Michael-Manning/Templog_PCB/Lenny_face.png

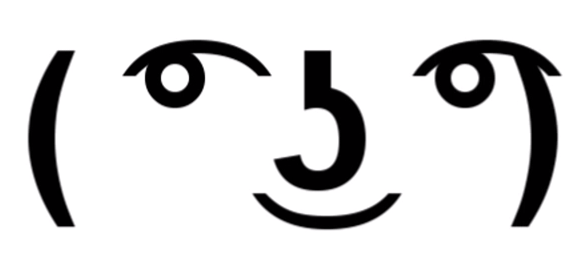
Lenny_face.png
