Michael-Manning/Templog_PCB/CAD/asm.FCStd

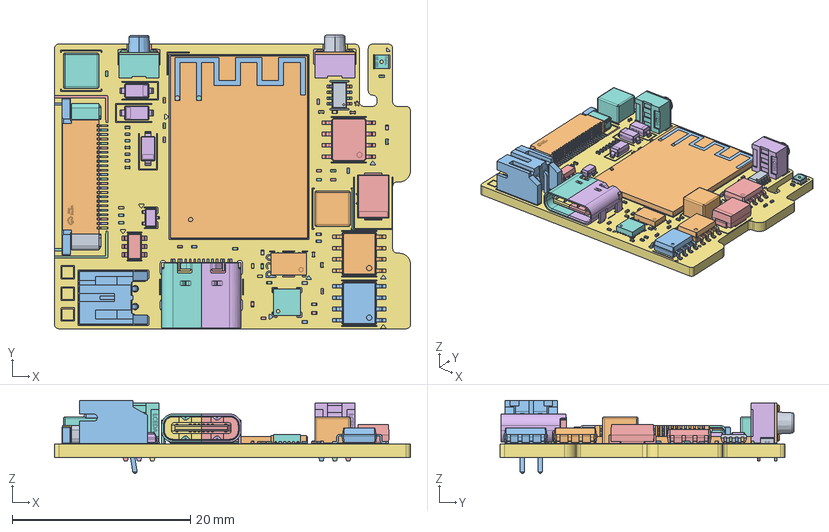
[picture p2: CAD file, 2025-06-27]
CAD/asm.FCStd
40.0 x 33.0 x 8.25 mm
C_0201_0603Metric
C_0201_0603Metric001
R_0201_0603Metric
C_0201_0603Metric002
SOT-23-6
C_0201_0603Metric003
C_0201_0603Metric004
C_0201_0603Metric005
R_0201_0603Metric001
SOIC-8_3.9x4.9mm_P1.27mm
C_0201_0603Metric006
R_0201_0603Metric002
R_0201_0603Metric003
R_0201_0603Metric004
C_0201_0603Metric007
R_0201_0603Metric005
C_0201_0603Metric008
Texas_S-PDSO-N12
JST_PH_S2B-PH-K_1x02_P2.00mm_Horizontal
C_0201_0603Metric009
R_0201_0603Metric006
D_SOD-123
FPC-SMD_AFC07-S24ECA-00
FPC-SMD_AFC07-S24ECA-001
FPC-SMD_AFC07-S24ECA-002
FPC-SMD_AFC07-S24ECA-003
FPC-SMD_AFC07-S24ECA-004
FPC-SMD_AFC07-S24ECA-005
FPC-SMD_AFC07-S24ECA-006
FPC-SMD_AFC07-S24ECA-007
FPC-SMD_AFC07-S24ECA-008
FPC-SMD_AFC07-S24ECA-009
FPC-SMD_AFC07-S24ECA-010
FPC-SMD_AFC07-S24ECA-011
FPC-SMD_AFC07-S24ECA-012
FPC-SMD_AFC07-S24ECA-013
FPC-SMD_AFC07-S24ECA-014
FPC-SMD_AFC07-S24ECA-015
FPC-SMD_AFC07-S24ECA-016
FPC-SMD_AFC07-S24ECA-017
FPC-SMD_AFC07-S24ECA-018
FPC-SMD_AFC07-S24ECA-019
FPC-SMD_AFC07-S24ECA-020
FPC-SMD_AFC07-S24ECA-021
FPC-SMD_AFC07-S24ECA-022
FPC-SMD_AFC07-S24ECA-023
FPC-SMD_AFC07-S24ECA-024
FPC-SMD_AFC07-S24ECA-025
FPC-SMD_AFC07-S24ECA-026
FPC-SMD_AFC07-S24ECA-027
SOIC-8_3.9x4.9mm_P1.27mm001
C_0201_0603Metric010
R_0201_0603Metric007
SOT-323_SC-70
C_0201_0603Metric011
R_0201_0603Metric008
R_0201_0603Metric009
C_0201_0603Metric012
R_0201_0603Metric010
C_0201_0603Metric013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
