Michael-Manning/Templog_PCB/CAD/display.FCStd

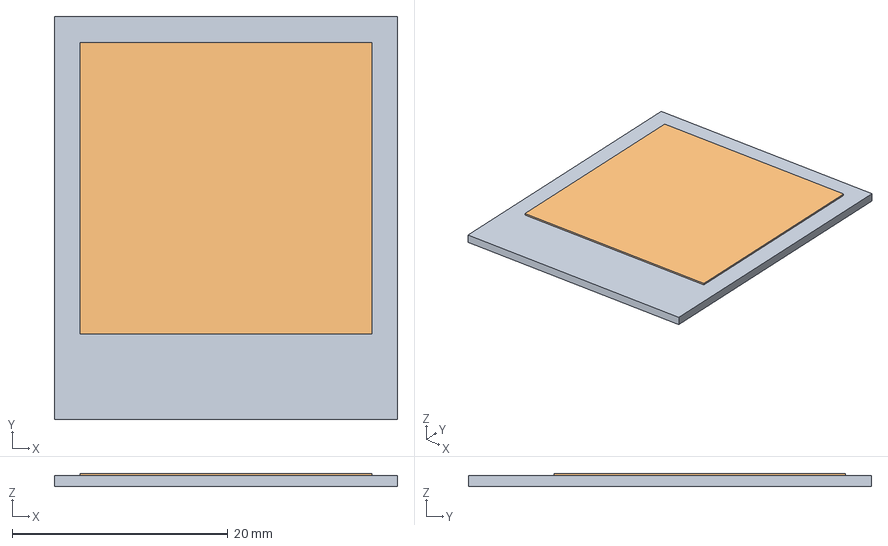
[picture p3: CAD file, 2025-06-27]
CAD/display.FCStd
31.8 x 37.3 x 1.20 mm
