Michael-Manning/Templog_PCB/templog_mainboard/PartLibrary/ESP32_S3_MINI_1/3DModel/ESP32-S3-MINI-1.STEP

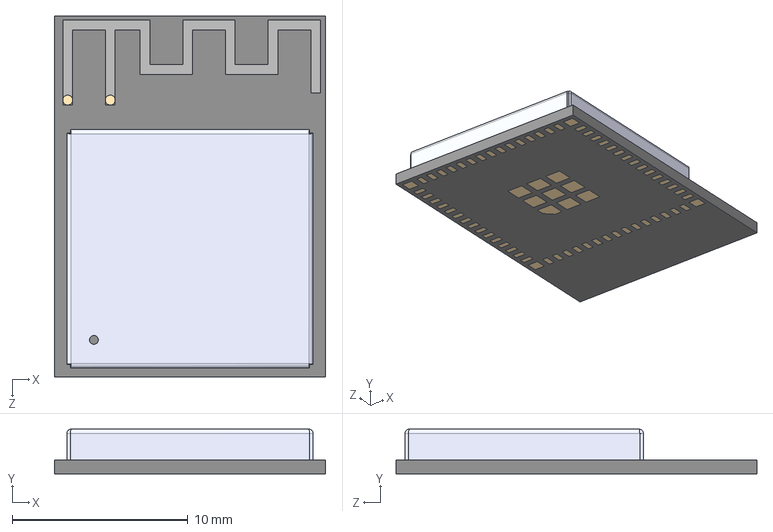
[picture p4: CAD file, 2025-06-13]
templog_mainboard/PartLibrary/ESP32_S3_MINI_1/3DModel/ESP32-S3-MINI-1.STEP
15.4 x 2.55 x 20.5 mm
