Michael-Manning/Templog_PCB/templog_mainboard/PartLibrary/K2-1109DE-D4SW-01/3DModel/KEY-TH_K2-L4.5-W2.9-H4.5-P3.0.step

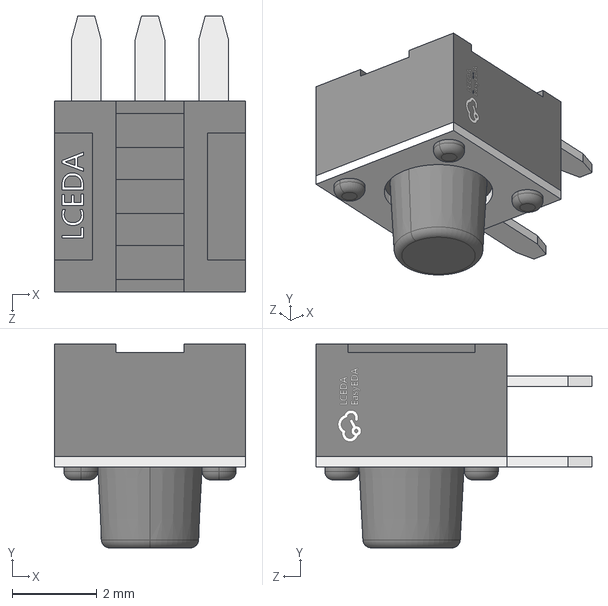
[picture p5: CAD file, 2025-06-16]
templog_mainboard/PartLibrary/K2-1109DE-D4SW-01/3DModel/KEY-TH_K2-L4.5-W2.9-H4.5-P3.0.step
4.50 x 4.80 x 6.50 mm
