Michael-Manning/Templog_PCB/templog_mainboard/PartLibrary/LTC2954CTS8_2_TRMPBF/3DModel/LTC2954CTS8-2_TRMPBF.step

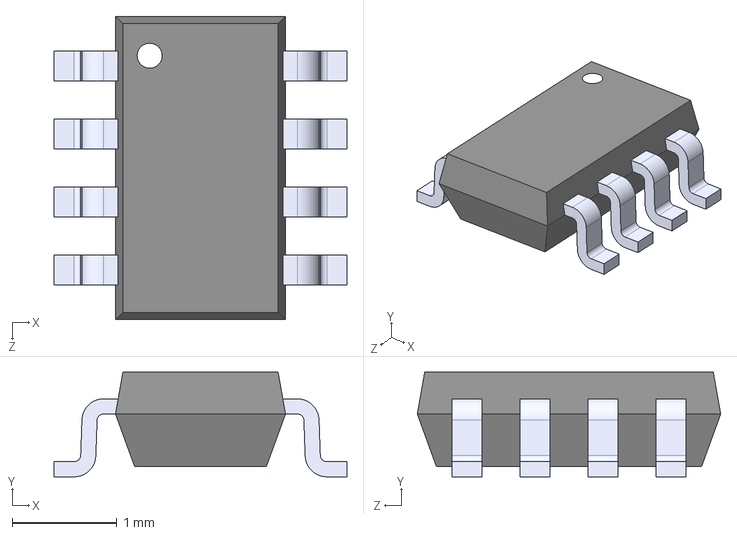
[picture p6: CAD file, 2025-06-17]
templog_mainboard/PartLibrary/LTC2954CTS8_2_TRMPBF/3DModel/LTC2954CTS8-2_TRMPBF.step
2.80 x 1.00 x 2.90 mm
