Michael-Manning/Templog_PCB/templog_mainboard/PartLibrary/SHT45/3DModel/SHT45-AD1B-R3.step

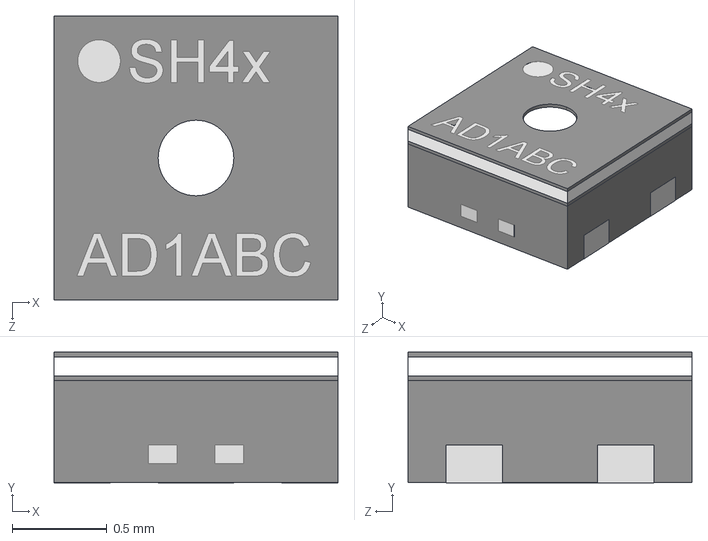
[picture p7: CAD file, 2025-06-16]
templog_mainboard/PartLibrary/SHT45/3DModel/SHT45-AD1B-R3.step
1.50 x 0.691 x 1.50 mm
