Michael-Manning/Templog_PCB/templog_mainboard/PartLibrary/SN74LVC1G79DBVR/3DModel/SN74LVC1G79DBVR.step

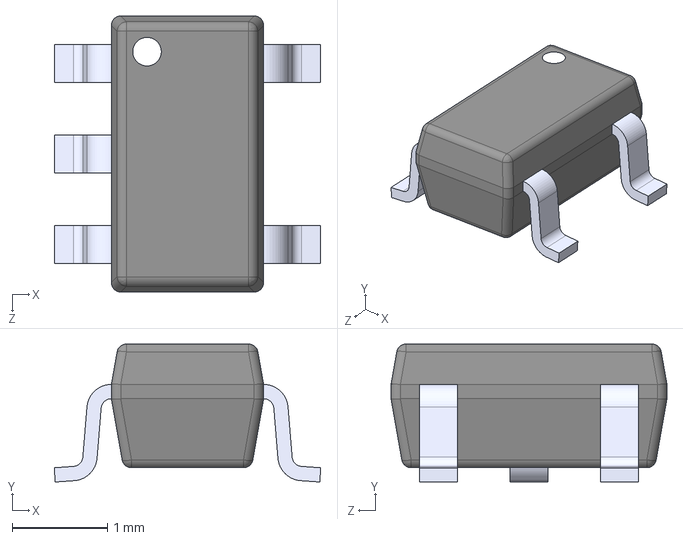
[picture p8: CAD file, 2025-06-13]
templog_mainboard/PartLibrary/SN74LVC1G79DBVR/3DModel/SN74LVC1G79DBVR.step
2.80 x 1.45 x 2.90 mm
