Michael-Manning/Templog_PCB/templog_mainboard/PartLibrary/TPS3422EGDRYR/3DModel/DRY0006A.stp

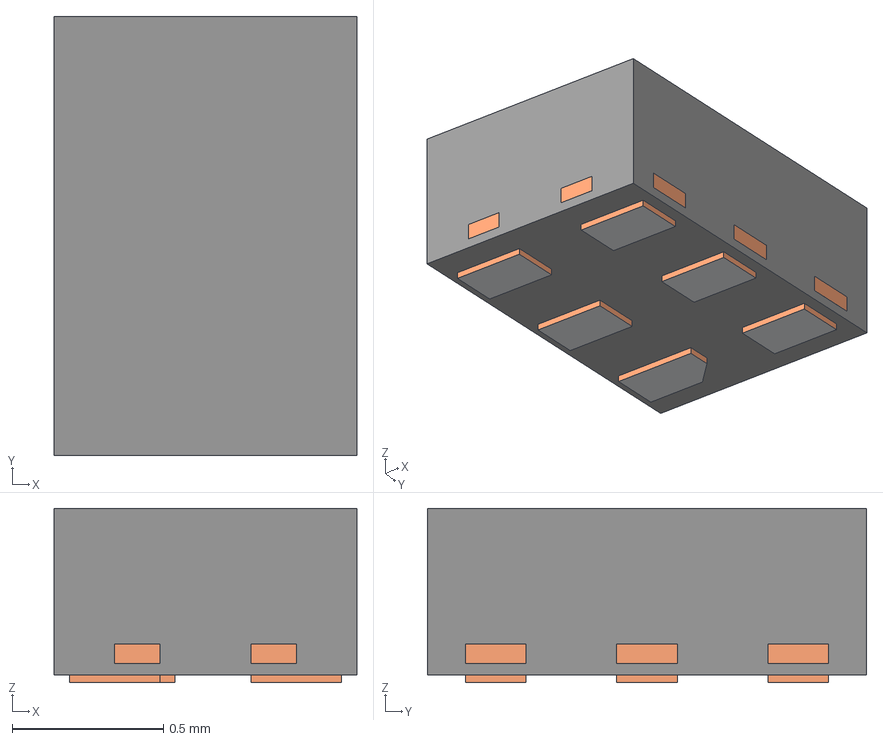
[picture p9: CAD file, 2025-06-13]
templog_mainboard/PartLibrary/TPS3422EGDRYR/3DModel/DRY0006A.stp
1.00 x 1.45 x 0.575 mm
BODY-SON
FRAME-DRY0006A
PIN1-ID
