Michael-Manning/Templog_PCB/CAD/front_plate.FCStd

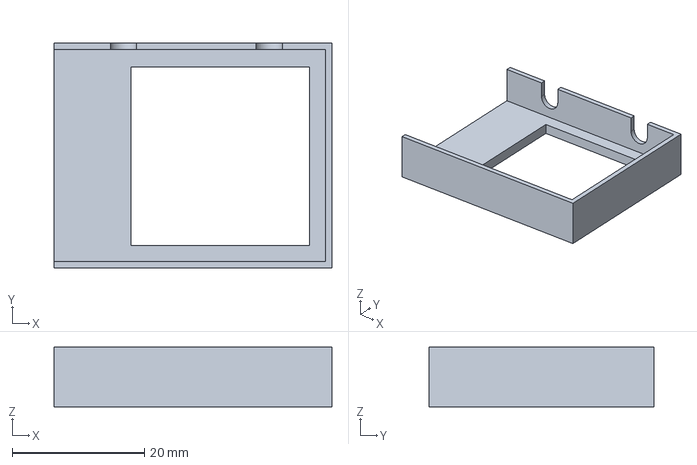
[picture p10: CAD file, 2025-06-27]
CAD/front_plate.FCStd
42.0 x 34.0 x 9.00 mm
