Michael-Manning/Templog_PCB/templog_mainboard/PartLibrary/BQ24075RGT/3DModel/BQ24075RGTR.step

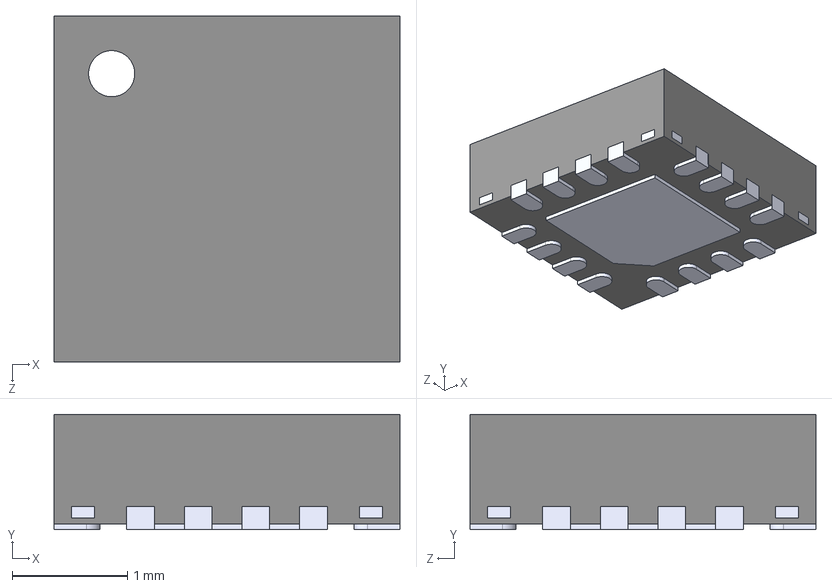
[picture p11: CAD file, 2025-06-16]
templog_mainboard/PartLibrary/BQ24075RGT/3DModel/BQ24075RGTR.step
3.00 x 1.00 x 3.00 mm
