Michael-Manning/Templog_PCB/templog_mainboard/templog_mainboard.kicad_pcb

## KiCad design templog_mainboard/templog_mainboard.kicad_pcb (2025-07-05)

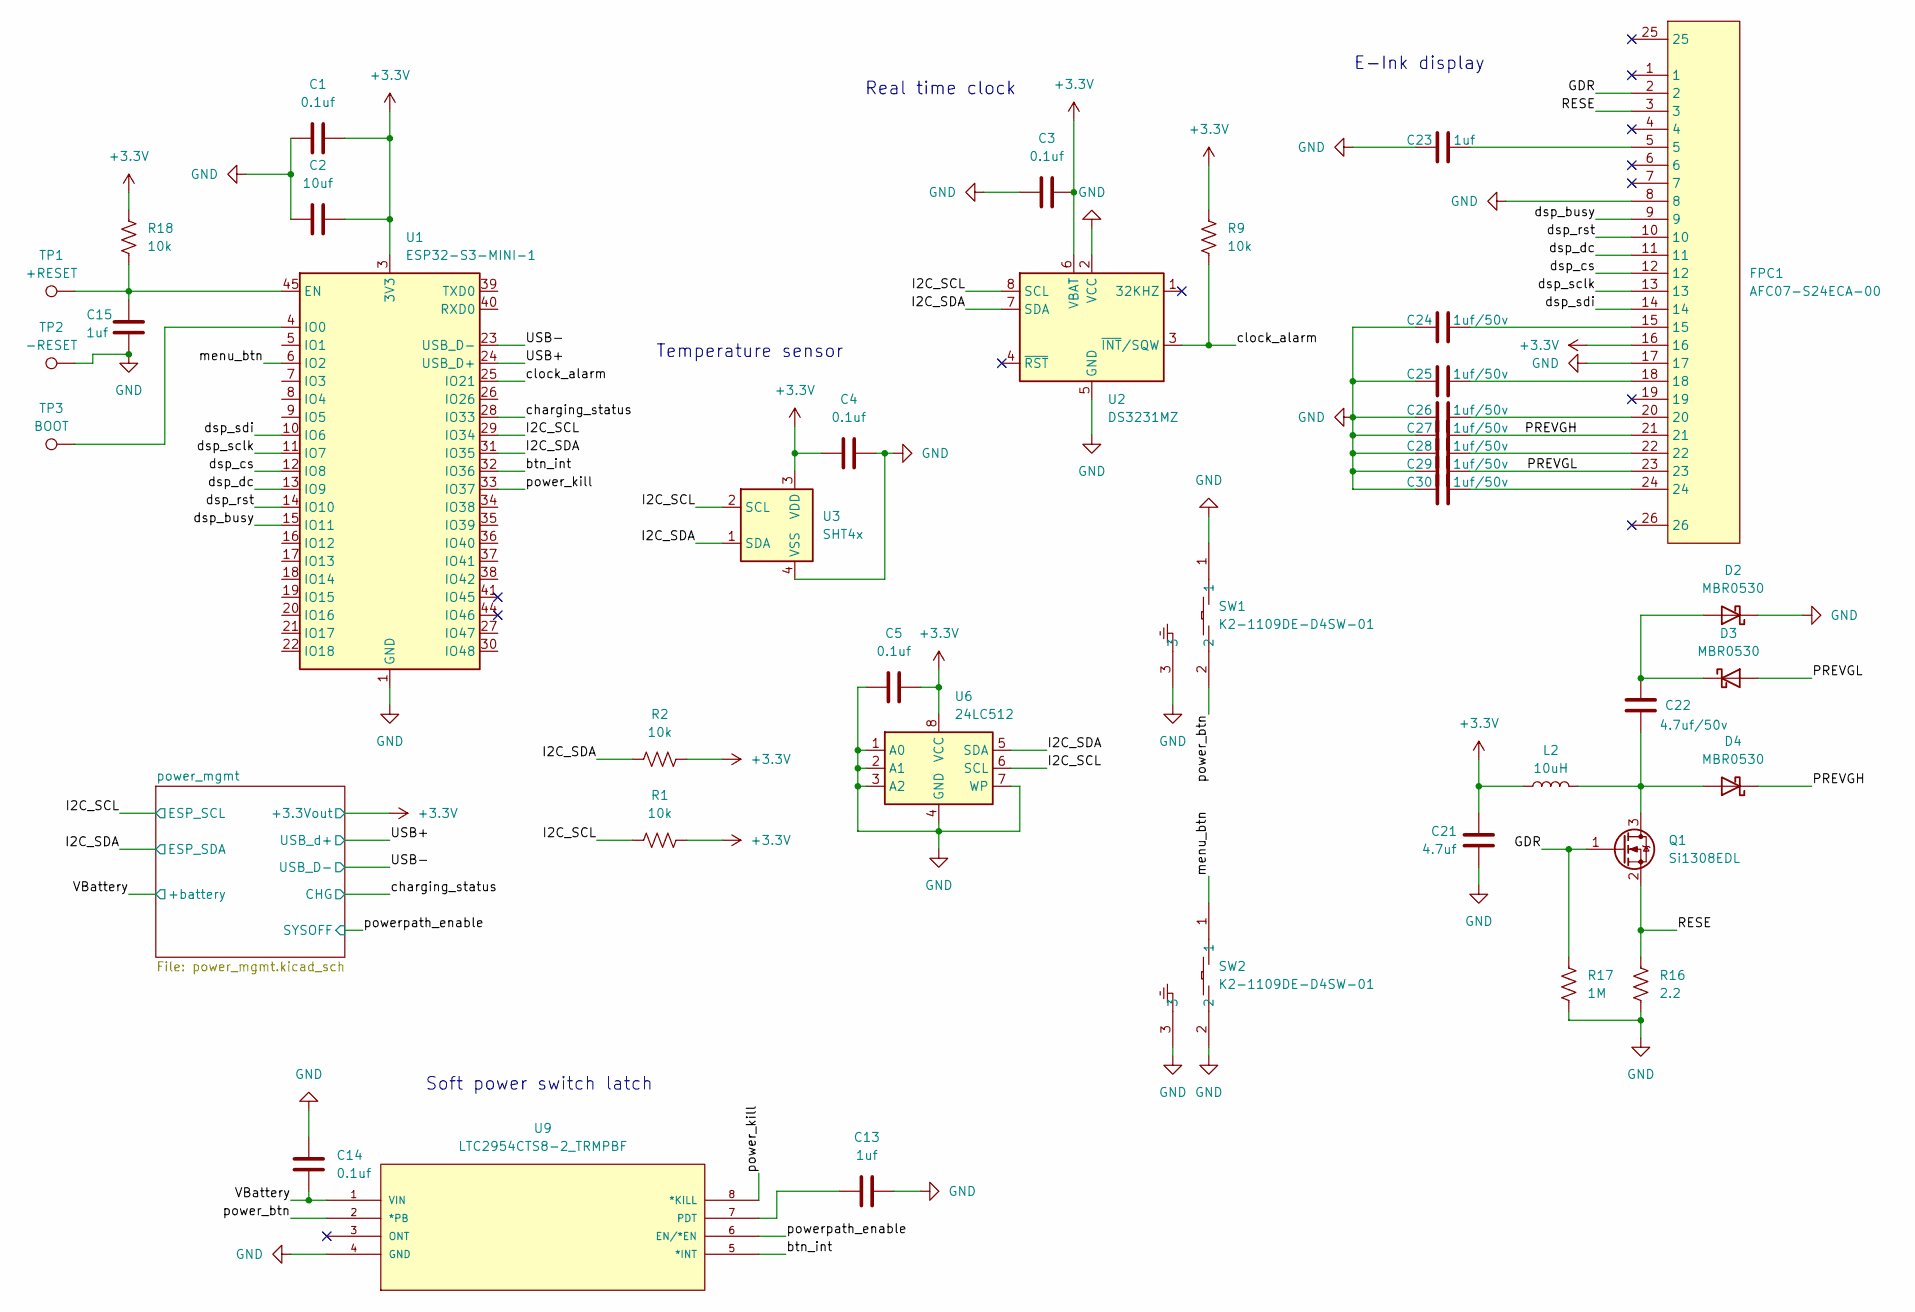
[picture p12: schematic templog_mainboard.kicad_sch]

Parts:
C1, C3, C4, C5, C14: 0.1uf; C_0402_1005Metric
C2: 10uf; C_0805_2012Metric
C13, C23: 1uf; C_0603_1608Metric
C15: 1uf; C_0402_1005Metric
C21: 4.7uf; C_0603_1608Metric
C22: 4.7uf/50v; C_0603_1608Metric
C24, C25, C26, C27, C28, C29, C30: 1uf/50v; C_0603_1608Metric
D2, D3, D4: MBR0530; D_SOD-123
FPC1: AFC07-S24ECA-00; FPC-SMD_AFC07-S24ECA-00; LCSC Part C262643
L2: 10uH; L_Sunlord_SWPA4030S
Q1: Si1308EDL; SOT-323_SC-70
R1, R2, R9, R18: 10k; R_0402_1005Metric
R16: 2.2; R_0402_1005Metric
R17: 1M; R_0402_1005Metric
SW1, SW2: K2-1109DE-D4SW-01; KEY-TH_K2-1109DE-CXXW-XX; LCSC Part C223806
TP1: +RESET; TestPoint_Pad_1.0x1.0mm
TP2: -RESET; TestPoint_Pad_1.0x1.0mm
TP3: BOOT; TestPoint_Pad_1.0x1.0mm
U1: ESP32-S3-MINI-1; ESP32-S2-MINI-1
U2: DS3231MZ; SOIC-8_3.9x4.9mm_P1.27mm
U3: SHT4x; Sensirion_DFN-4_1.5x1.5mm_P0.8mm_SHT4x_NoCentralPad
U6: 24LC512; SOIC-8_3.9x4.9mm_P1.27mm
U9: LTC2954CTS8-2_TRMPBF; TSOT-23_TS8; MANUFACTURER_PART_NUMBER ltc2954cts81

Connections:
+3.3V: C1.2, C2.2, C3.2, C4.1, C5.2, C21.1, FPC1.16, L2.1, R1.2, R2.2, R9.1, R18.1, U1.3 (3V3), U2.6 (VBAT), U3.3 (VDD), U6.8 (VCC); also elsewhere on the board
/GDR: FPC1.2, Q1.1 (G), R17.2
/I2C_SCL: R1.1, U1.29 (IO34), U2.8 (SCL), U3.2 (SCL), U6.6 (SCL); also elsewhere on the board
/I2C_SDA: R2.1, U1.31 (IO35), U2.7 (SDA), U3.1 (SDA), U6.5 (SDA); also elsewhere on the board
/PREVGH: C27.2, D4.1 (K), FPC1.21
/PREVGL: C29.2, D3.2 (A), FPC1.23
/RESE: FPC1.3, Q1.2 (S), R16.2
/USB+: U1.24 (USB_D+); also elsewhere on the board
/USB-: U1.23 (USB_D-); also elsewhere on the board
/VBattery: C14.1, U9.1 (VIN); also elsewhere on the board
/btn_int: U1.32 (IO36), U9.5 (*INT)
/charging_status: U1.28 (IO33); also elsewhere on the board
/clock_alarm: R9.2, U1.25 (IO21), U2.3 (~INT/SQW)
/dsp_busy: FPC1.9, U1.15 (IO11)
/dsp_cs: FPC1.12, U1.12 (IO8)
/dsp_dc: FPC1.11, U1.13 (IO9)
/dsp_rst: FPC1.10, U1.14 (IO10)
/dsp_sclk: FPC1.13, U1.11 (IO7)
/dsp_sdi: FPC1.14, U1.10 (IO6)
/menu_btn: SW2.1, U1.6 (IO2)
/power_btn: SW1.2, U9.2 (*PB)
/power_kill: U1.33 (IO37), U9.8 (*KILL)
/powerpath_enable: U9.6 (EN/*EN); also elsewhere on the board
GND: C1.1, C2.1, C3.1, C4.2, C5.1, C13.2, C14.2, C15.2, C21.2, C23.1, C24.1, C25.1, C26.1, C27.1, C28.1, C29.1, C30.1, D2.1 (K), FPC1.8, FPC1.17, R16.1, R17.1, SW1.1, SW1.3, SW2.2, SW2.3, TP2.1, U1.1 (GND), U1.2 (GND), U1.42 (GND), U1.43 (GND), U1.46 (GND), U1.47 (GND), U1.48 (GND), U1.49 (GND), U1.50 (GND), U1.51 (GND), U1.52 (GND), U1.53 (GND), U1.54 (GND), U1.55 (GND), U1.56 (GND), U1.57 (GND), U1.58 (GND), U1.59 (GND), U1.60 (GND), U1.61 (GND), U1.62 (GND), U1.63 (GND), U1.64 (GND), U1.65 (GND), U2.2 (VCC), U2.5 (GND), U3.4 (VSS), U6.1 (A0), U6.2 (A1), U6.3 (A2), U6.4 (GND), U6.7 (WP), U9.4 (GND); also elsewhere on the board
unnamed: C23.2, FPC1.5
unnamed: C24.2, FPC1.15
unnamed: C25.2, FPC1.18
unnamed: C26.2, FPC1.20
unnamed: C28.2, FPC1.22
unnamed: C30.2, FPC1.24
unnamed: C22.1, D2.2 (A), D3.1 (K)
unnamed: C22.2, D4.2 (A), L2.2, Q1.3 (D)
unnamed: C15.1, R18.2, TP1.1, U1.45 (EN)
unnamed: TP3.1, U1.4 (IO0)
unnamed: C13.1, U9.7 (PDT)

Notes on the sheet:
Soft power switch latch
Real time clock
Temperature sensor
E-Ink display

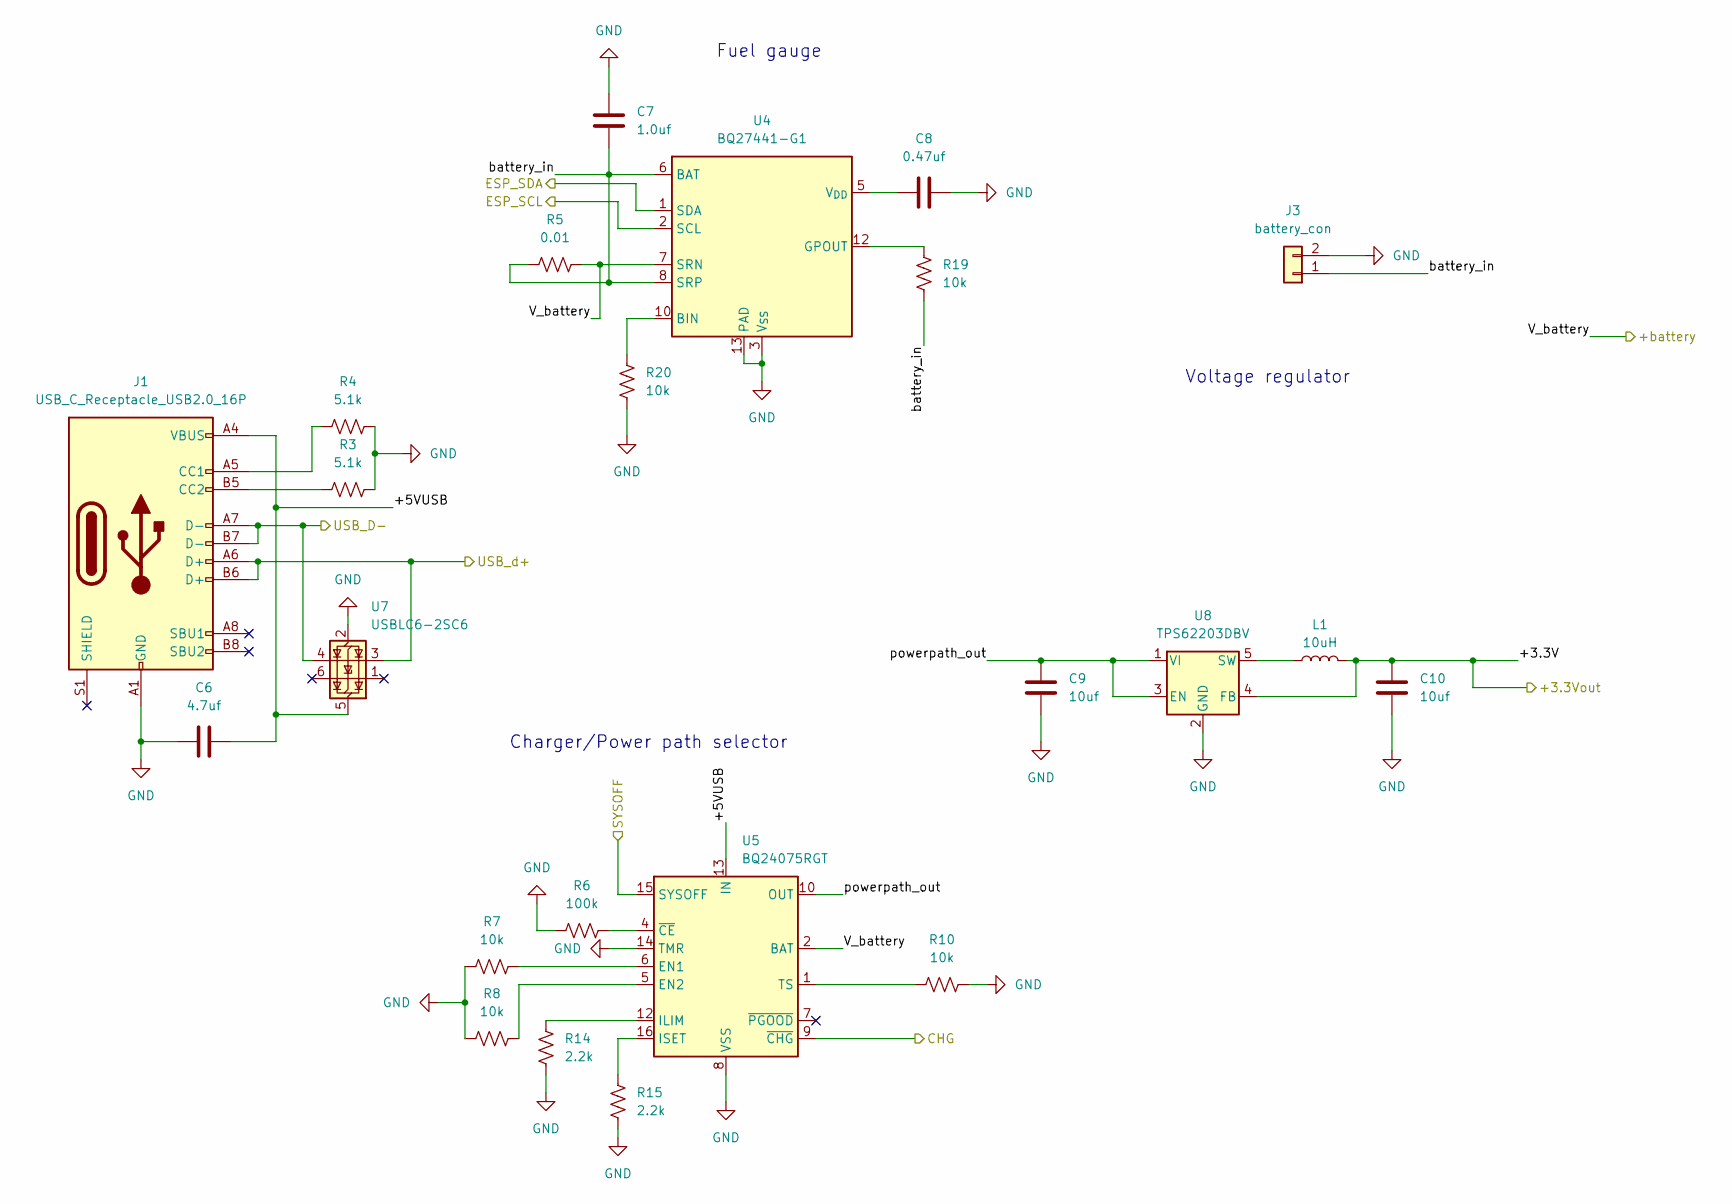
[picture p13: schematic power_mgmt.kicad_sch]

Parts:
C6: 4.7uf; C_0603_1608Metric
C7: 1.0uf; C_0402_1005Metric
C8: 0.47uf; C_0402_1005Metric
C9, C10: 10uf; C_0805_2012Metric
J1: USB_C_Receptacle_USB2.0_16P; USB_C_Receptacle_GCT_USB4105-xx-A_16P_TopMnt_Horizontal
J3: battery_con; JST_PH_S2B-PH-K_1x02_P2.00mm_Horizontal
L1: 10uH; L_Sunlord_SWPA4030S
R3, R4: 5.1k; R_0402_1005Metric
R5: 0.01; R_0402_1005Metric
R6: 100k; R_0402_1005Metric
R7, R8, R10, R19, R20: 10k; R_0402_1005Metric
R14, R15: 2.2k; R_0402_1005Metric
U4: BQ27441-G1; Texas_S-PDSO-N12
U5: BQ24075RGT; VQFN-16-1EP_3x3mm_P0.5mm_EP1.6x1.6mm
U7: USBLC6-2SC6; SOT-23-6
U8: TPS62203DBV; SOT-23-5

Connections:
+3.3V: C10.2, L1.2, U8.4 (FB); also elsewhere on the board
/I2C_SCL: U4.2 (SCL); also elsewhere on the board
/I2C_SDA: U4.1 (SDA); also elsewhere on the board
/USB+: J1.A6 (D+), J1.B6 (D+), U7.3 (I/O2); also elsewhere on the board
/USB-: J1.A7 (D-), J1.B7 (D-), U7.4 (I/O2); also elsewhere on the board
/VBattery: R5.2, U4.7 (SRN), U5.2 (BAT), U5.3 (BAT); also elsewhere on the board
/charging_status: U5.9 (~CHG); also elsewhere on the board
/power_mgmt/+5VUSB: C6.1, J1.A4 (VBUS), J1.A9 (VBUS), J1.B4 (VBUS), J1.B9 (VBUS), U5.13 (IN), U7.5 (VBUS)
/power_mgmt/battery_in: C7.2, J3.1, R5.1, R19.1, U4.6 (BAT), U4.8 (SRP)
/power_mgmt/powerpath_out: C9.2, U5.10 (OUT), U5.11 (OUT), U8.1 (VI), U8.3 (EN)
/powerpath_enable: U5.15 (SYSOFF); also elsewhere on the board
GND: C6.2, C7.1, C8.1, C9.1, C10.1, J1.A1 (GND), J1.A12 (GND), J1.B1 (GND), J1.B12 (GND), J3.2, R3.2, R4.2, R6.1, R7.1, R8.1, R10.2, R14.1, R15.1, R20.2, U4.3 (V_{SS}), U4.13 (PAD), U5.8 (VSS), U5.14 (TMR), U5.17 (VSS), U7.2 (GND), U8.2 (GND); also elsewhere on the board
unnamed: J1.A5 (CC1), R4.1
unnamed: J1.B5 (CC2), R3.1
unnamed: R20.1, U4.10 (BIN)
unnamed: R19.2, U4.12 (GPOUT)
unnamed: C8.2, U4.5 (V_{DD})
unnamed: R7.2, U5.6 (EN1)
unnamed: R8.2, U5.5 (EN2)
unnamed: R14.2, U5.12 (ILIM)
unnamed: R15.2, U5.16 (ISET)
unnamed: R10.1, U5.1 (TS)
unnamed: R6.2, U5.4 (~CE)
unnamed: L1.1, U8.5 (SW)

Notes on the sheet:
Voltage regulator
Charger/Power path selector
Fuel gauge

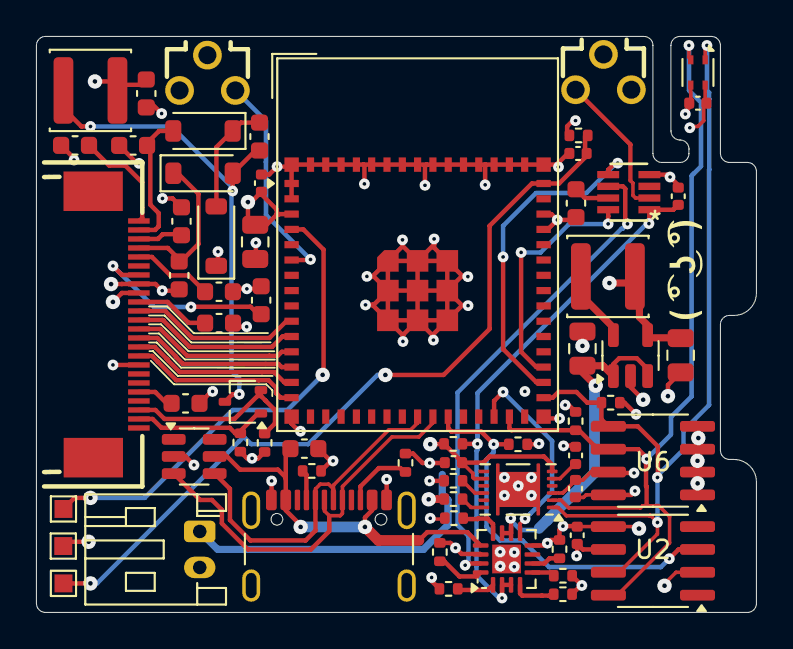
[picture p14: board templog_mainboard.kicad_pcb from above]

Board: 4 copper layers, 40.0 x 32.0 mm, 63 parts (0 on the bottom side), 50 nets.
