Michael-Manning/Templog_PCB/(commit log)

2025-06-13 time for electricity
    [DRY0006A.stp, ESP32-S3-MINI-1.STEP, SN74LVC1G79DBVR.step, power_mgmt.kicad_sch, templog_mainboard.kicad_pcb, templog_mainboard.kicad_sch]
2025-07-03 this is an electricity PCB
    [power_mgmt.kicad_sch, templog_mainboard.kicad_pcb, templog_mainboard.kicad_sch]
2025-07-03 ummmmmm uggg uhhh
    [templog_mainboard.kicad_pcb]
2025-07-05 uuhhuh umm electriciadty
    [templog_mainboard.kicad_pcb]
